fixtreza/monitoring-position-and-movement-of-cattle-IOT-based/Documentation/posisi alat.PNG

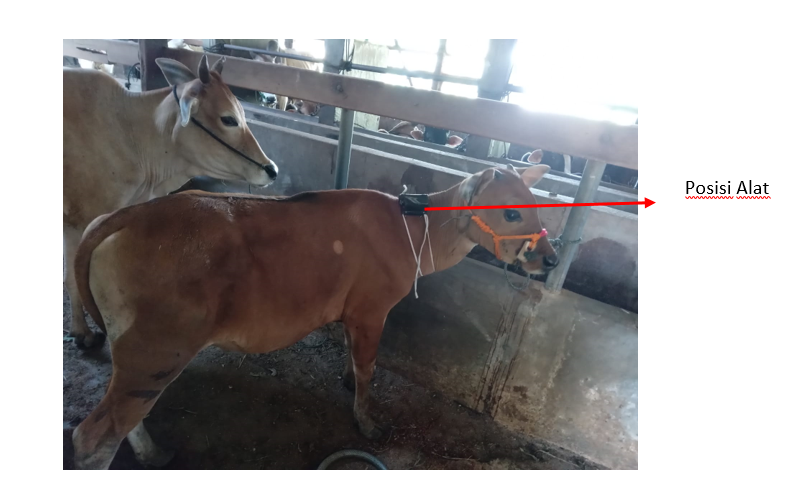
Documentation/posisi alat.PNG
