fixtreza/monitoring-position-and-movement-of-cattle-IOT-based/Documentation/prototype 3.PNG

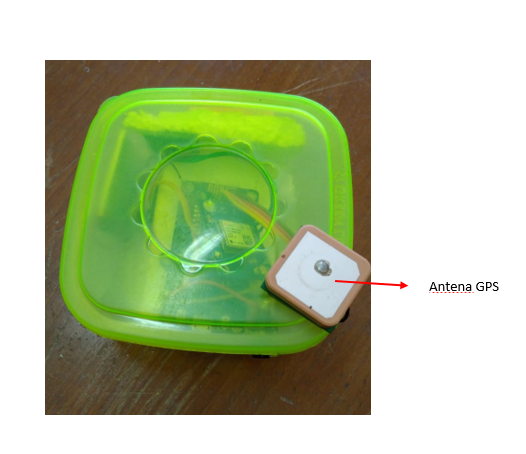
Documentation/prototype 3.PNG
