fixtreza/monitoring-position-and-movement-of-cattle-IOT-based/Documentation/digram sistem.png

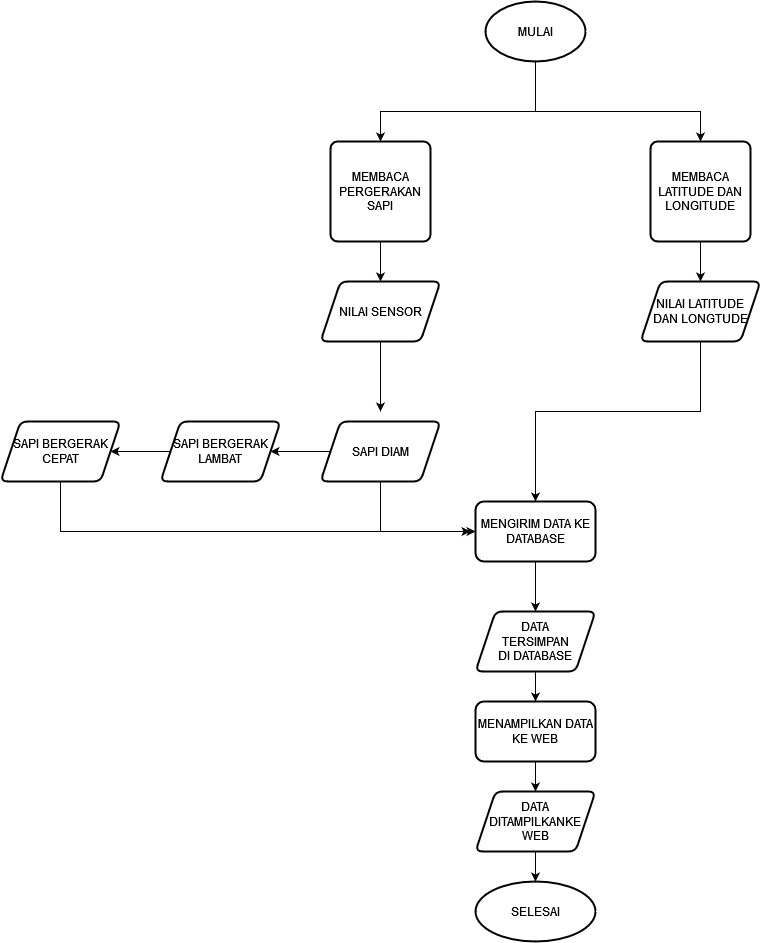
Documentation/digram sistem.png
