fixtreza/monitoring-position-and-movement-of-cattle-IOT-based/Documentation/prototype 1.PNG

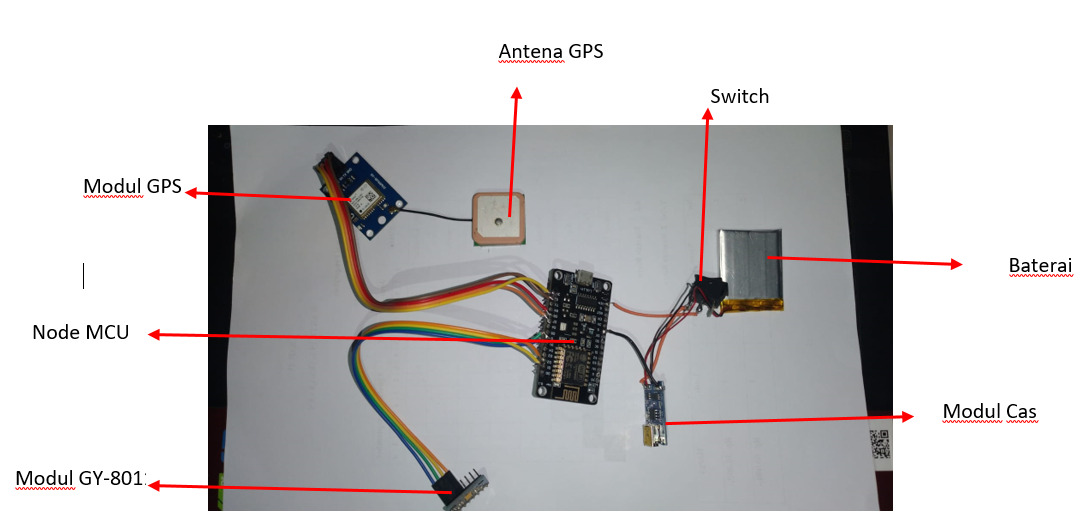
Documentation/prototype 1.PNG
