fixtreza/monitoring-position-and-movement-of-cattle-IOT-based/Documentation/prototype 2.PNG

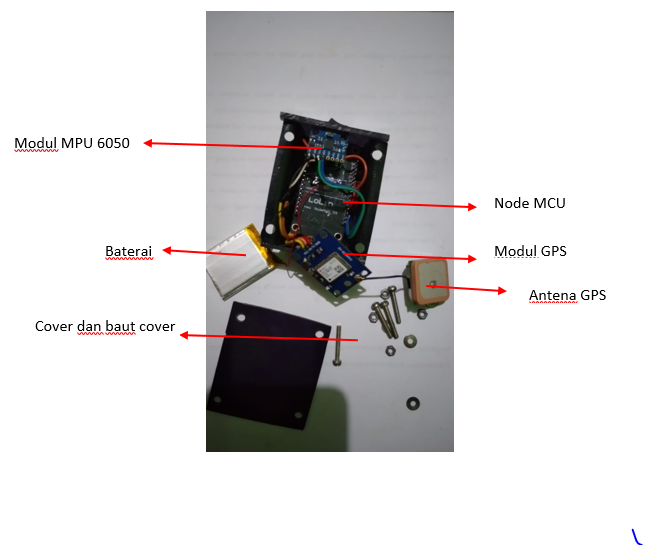
Documentation/prototype 2.PNG
