fixtreza/monitoring-position-and-movement-of-cattle-IOT-based/Documentation/prototype 4.PNG

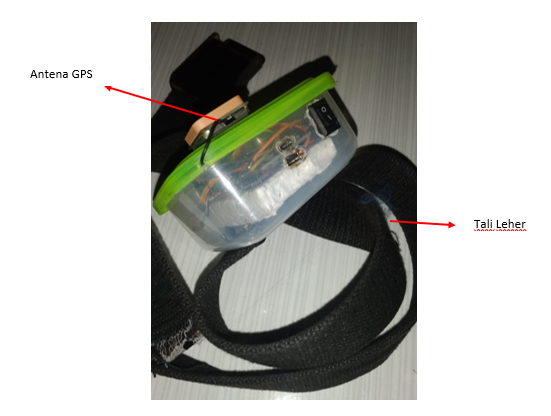
Documentation/prototype 4.PNG
